matthewthomasbeck/Prowl/frontend/src/assets/earth-map-4k.jpg

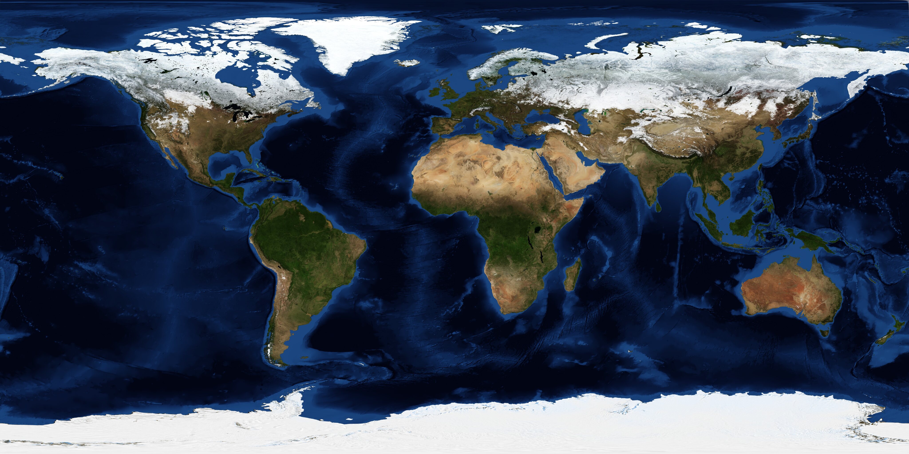
frontend/src/assets/earth-map-4k.jpg
