matthewthomasbeck/Prowl/frontend/src/assets/moon-ground.jpg

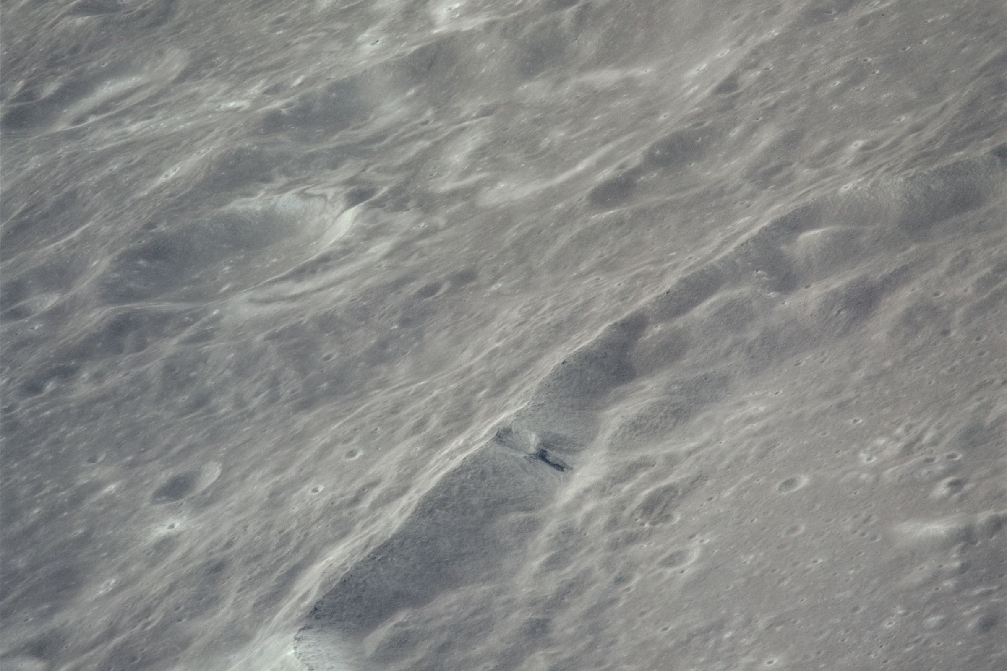
frontend/src/assets/moon-ground.jpg
