matthewthomasbeck/Prowl/frontend/src/assets/moon-map-2k.jpg

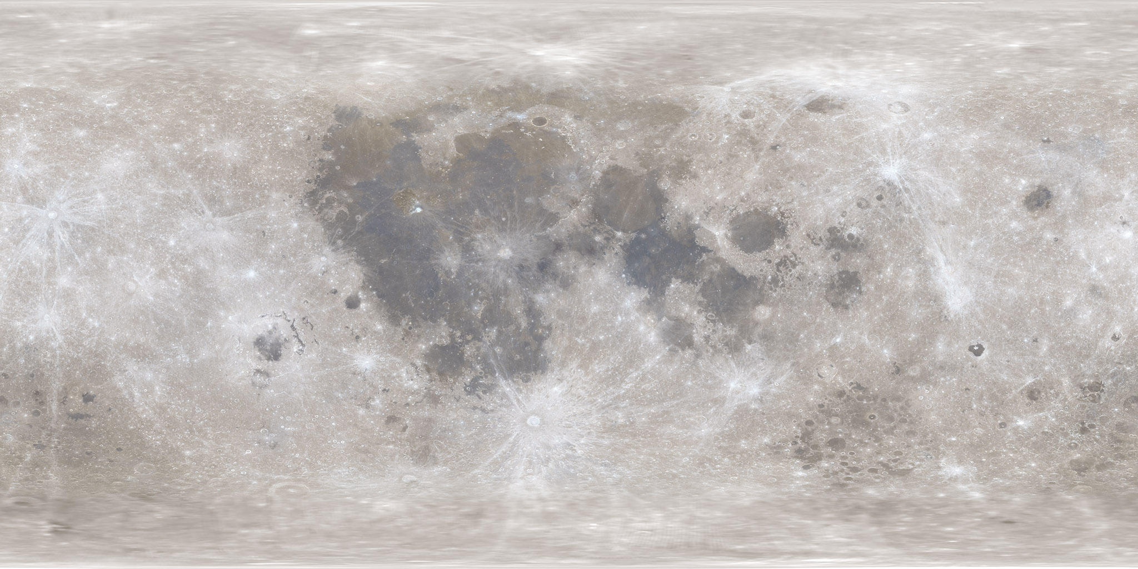
frontend/src/assets/moon-map-2k.jpg
