matthewthomasbeck/Prowl/images/frontend-saved_pictures.jpg

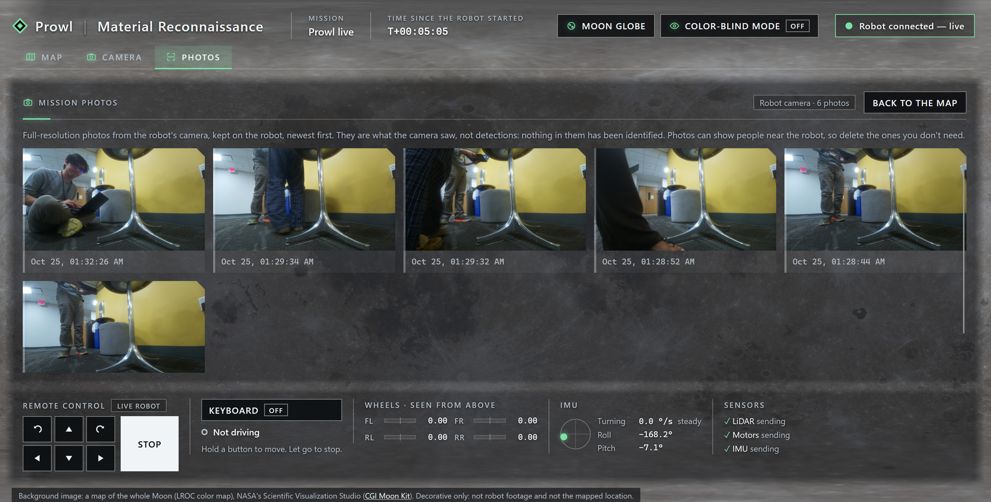
images/frontend-saved_pictures.jpg
