matthewthomasbeck/Prowl/images/propped_up_robot.jpg

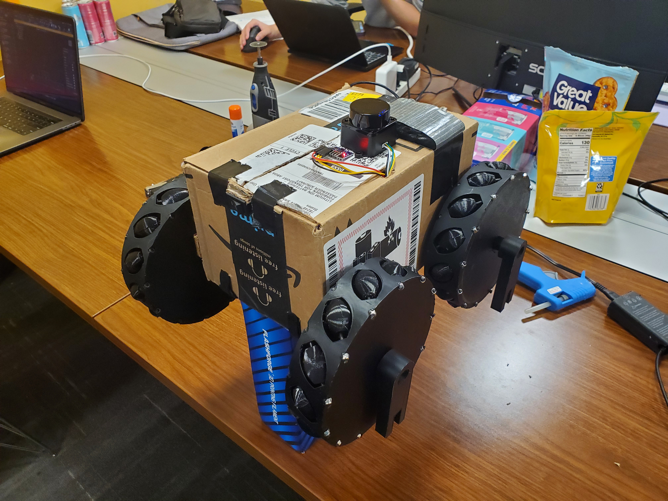
images/propped_up_robot.jpg
