matthewthomasbeck/Prowl/images/finished_robot-parts_exposed.jpg

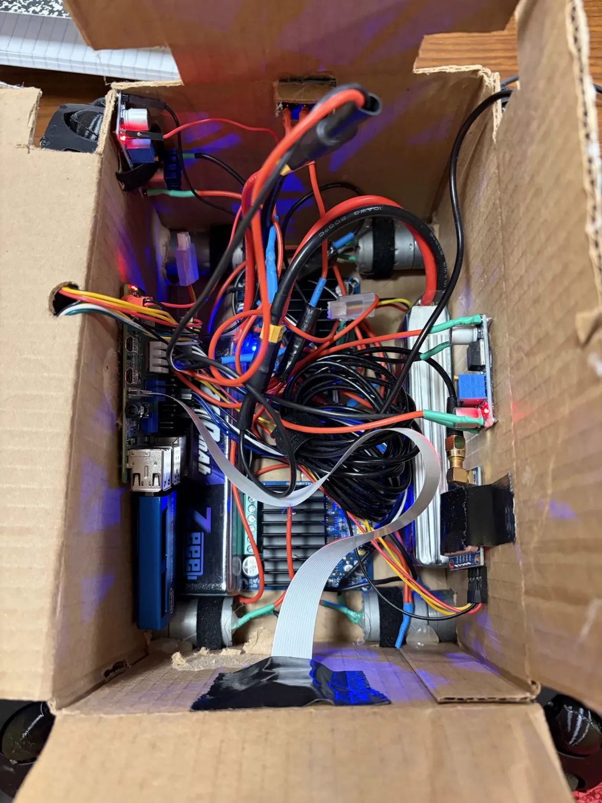
images/finished_robot-parts_exposed.jpg
