matthewthomasbeck/Prowl/images/parts_disassembled.jpg

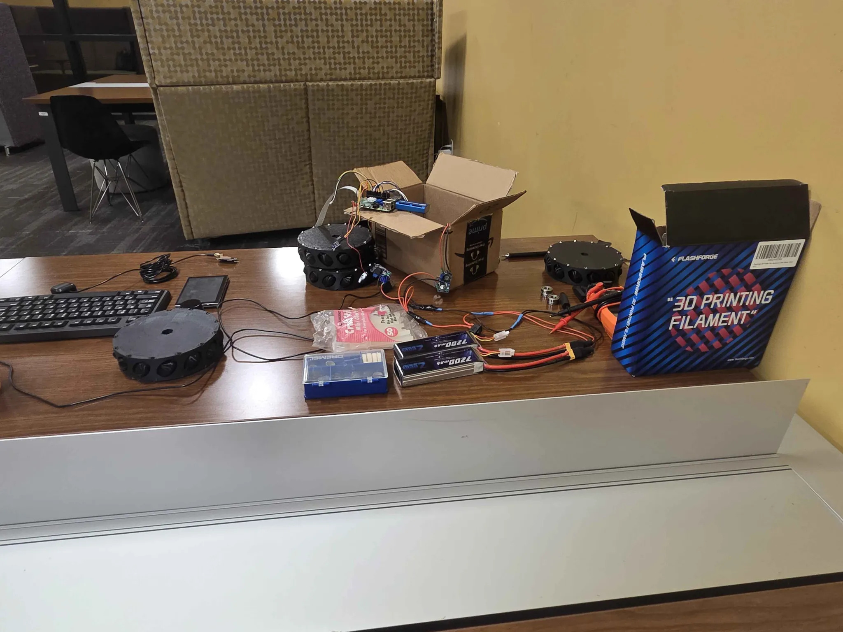
images/parts_disassembled.jpg
