matthewthomasbeck/Prowl/3d_parts/buttress.stl

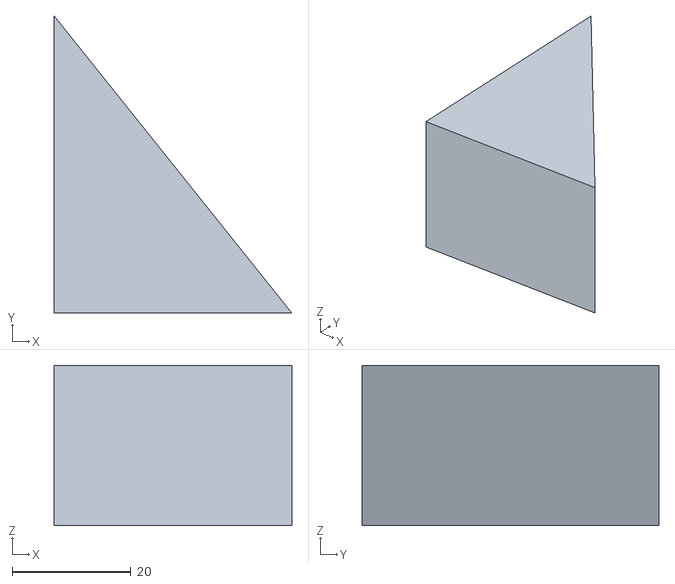
[picture p16: CAD file, 2026-10-25]
3d_parts/buttress.stl
40.0 x 50.0 x 27.0
