matthewthomasbeck/Prowl/3d_parts/connector_arm.stl

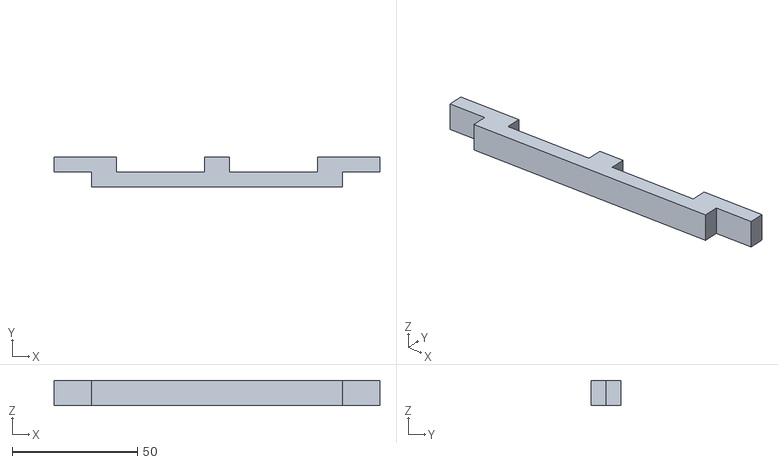
[picture p17: CAD file, 2026-10-24]
3d_parts/connector_arm.stl
130.0 x 12.0 x 10.0
