matthewthomasbeck/Prowl/3d_parts/t_bracket.stl

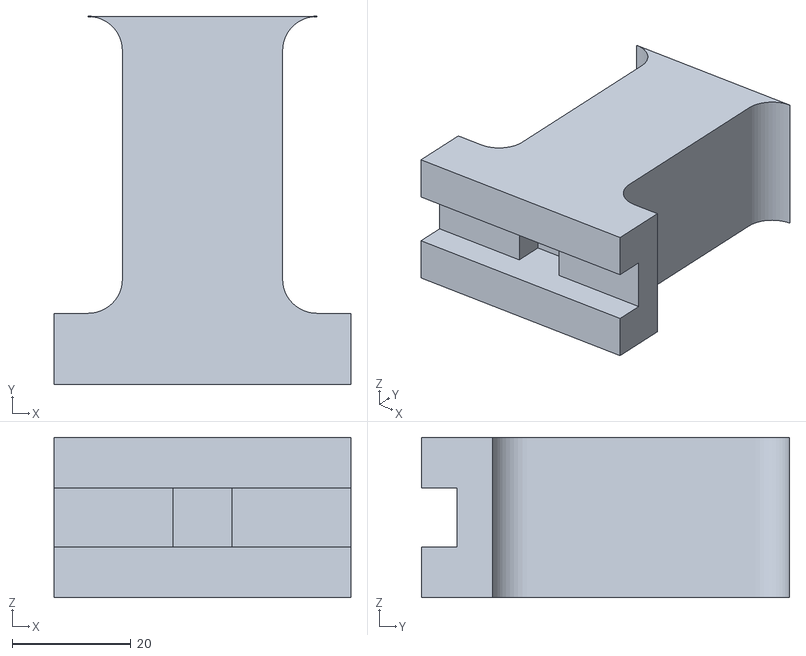
[picture p18: CAD file, 2026-10-24]
3d_parts/t_bracket.stl
50.0 x 62.0 x 27.0
