matthewthomasbeck/Prowl/3d_parts/wheel_arm.stl

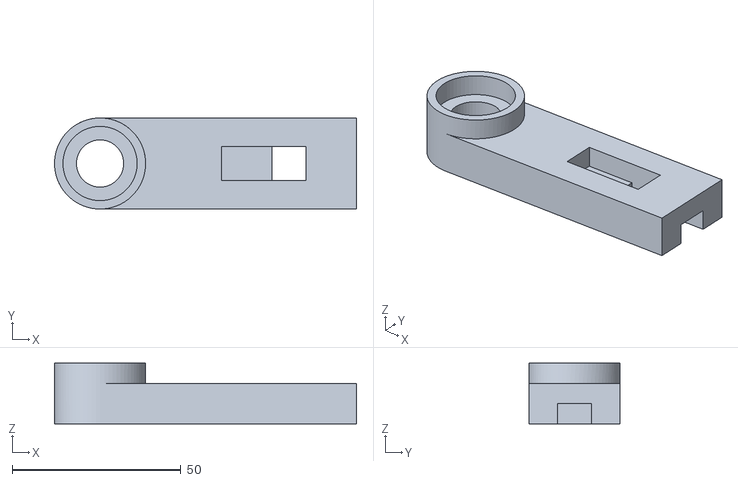
[picture p19: CAD file, 2026-10-24]
3d_parts/wheel_arm.stl
89.5 x 27.0 x 18.0
