matthewthomasbeck/Prowl/images/3d_printer.jpg

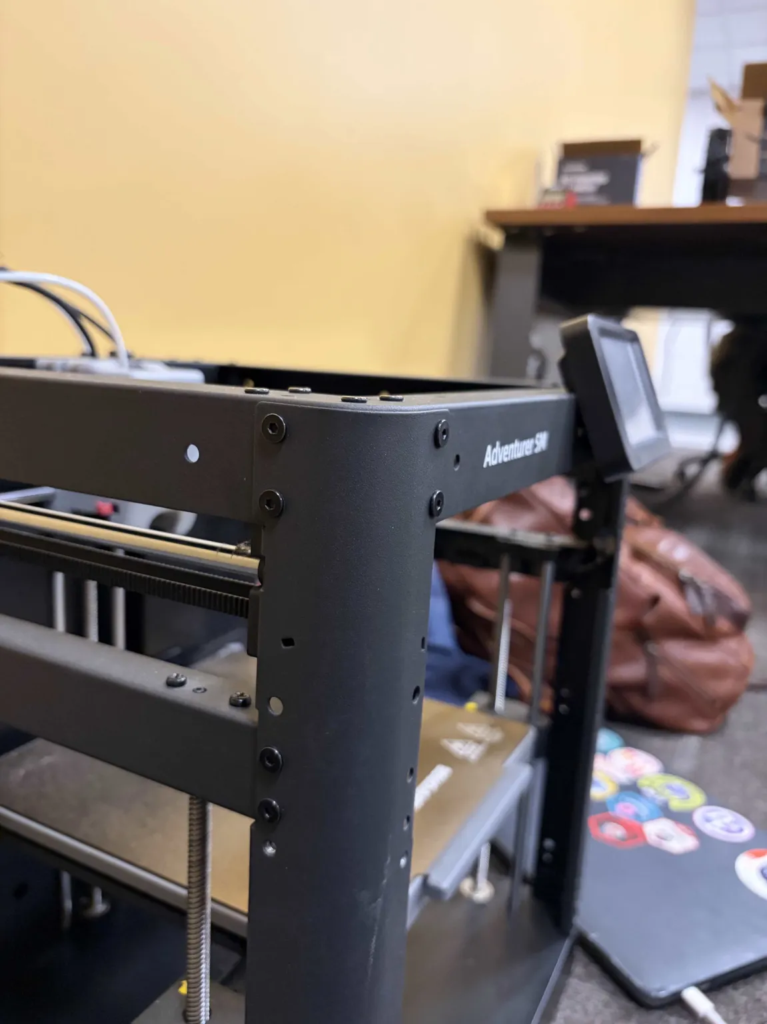
images/3d_printer.jpg
