matthewthomasbeck/Prowl/edge/src/prowl_dashboard_bridge/config/dashboard_bridge.yaml

dashboard_bridge:
  ros__parameters:
    host: 0.0.0.0           # listen on every network interface
    port: 8000              # the dashboard's web server forwards /ws and /api here (frontend/vite.config.js)
    drive_token: ""         # empty = anyone who can reach the port can drive; set one before using a shared network

    # Drive requests are fractions of these top speeds. Write them with a decimal point (1.0, not 1).
    # They're set so a full request is full motor duty: on Prowl's wheels, slow driving is harder on the
    # wheels than fast. If motor_driver.yaml's max_linear_speed or wheel geometry changes, change these too.
    linear_speed: 1.0       # m/s, forward/back and strafe: motor_driver's max_linear_speed
    angular_speed: 3.34     # rad/s: max_linear_speed / ((wheel_separation + wheel_base) / 2), rounded up
    drive_timeout: 0.3      # s without a drive request before a stop is sent (the motor driver's own is 0.5)

    mission_name: Prowl live  # shown as the mission in the dashboard's header

    # Where the LiDAR sits on the robot (base_link), for placing scan points around the robot. TODO: measure.
    laser_x: 0.0            # m forward
    laser_y: 0.0            # m left
    laser_yaw: 0.0          # rad counter-clockwise

    # How often the dashboards get each topic (the newest message wins in between).
    max_scan_points: 180
    scan_rate: 5.0          # Hz
    motor_status_rate: 10.0 # Hz
    imu_rate: 5.0           # Hz: each imu message is the average of the readings since the last one
    gps_rate: 2.0           # Hz: the GPS driver sends a fix once a second

    stale_after: 2.0        # s: the robot counts as connected while the LiDAR, motors, IMU, camera or GPS sent something this recently

    # Every photo the camera takes is kept here, for the dashboard's photos page. A relative path starts where
    # the bridge was started (edge/ in the dev container). Past max_photos (about 1 MB each), the oldest goes.
    photo_dir: data/photos
    max_photos: 200
