matthewthomasbeck/Prowl/(commit log)

2026-10-24 Designed adequate wheel arm
    [wheel_arm.stl]
2026-10-24 Added t bracket
    [t_bracket.stl]
2026-10-24 Add Prowl frontend dashboard (basic layout, demo mode)
    Minimal React + Vite + JavaScript app with plain CSS, in frontend/.
    Prowl heading and connection status, a clear "Demo mode - robot not
    connected" banner, and placeholders for the map and camera plus an
    observations panel. No UI library, no backend address, and no real data:
    the connection method and data format are not decided yet.
    The README documents how to run it and notes AI assistance.
2026-10-24 Replace basic frontend with the finished Prowl dashboard
    Mission-style React dashboard with clearly labeled simulated data:
    zoomable Moon exploration map, interactive Moon globe, points of
    interest and simulated obstacles, sample inspector with local-only
    "Queued locally - demo only" review queue, camera placeholder,
    mobile/tablet/desktop layouts, and a color-blind mode.
    No backend addresses or real robot readings; the README documents
    AI assistance, starter files and the two credited NASA images.
2026-10-24 edge: motor driver, motor panel, Docker dev setup, roadmap
    - Docker dev environment (docker/Dockerfile, docker/dev.sh) that runs ROS2
    Jazzy on the Pi, plus ./prowl to start it, build, and open the motor panel
    - prowl_motor_driver: mecanum /cmd_vel mixing, per-wheel /wheel_cmd,
    acceleration ramp, command timeout, dry-run mode
    - motor_panel: terminal UI with hold-to-drive, strafing, wheel tests, and
    live mode for one run only
    - README.md: setup, usage, safety and troubleshooting
    - ROADMAP.md: LD19 LiDAR and MPU6050 drivers, Cartographer mapping, and the
    rosbridge link to the dashboard
    [motor_driver.yaml]
2026-10-24 Connect the dashboard to a live backend for the space pitch
    Backend (backend/): FastAPI server between the rover and the dashboard.
    - Rover streams pose, LiDAR map, scans, findings and status over /ws/robot;
    camera samples get codes P-001.., LiDAR obstacles O-001..
    - Dashboards get a snapshot then live updates; review status, notes and
    queued reports are saved per run and shared, during and after a run.
    - Every run is recorded and can be replayed; resume after Wi-Fi drops.
    - tools/fake_robot.py simulates the rover in a mock Moon area (LiDAR
    raycasting, obstacle clustering, camera finds), labeled as simulator data.
    - deploy/setup_ec2.sh sets up Amazon Linux 2023 in one command and
    bui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
2026-10-24 edge: LD19 LiDAR and MPU6050 IMU drivers, vibration-proof gyro calibration
    - prowl_ld19_driver: LD19 packet parser with CRC-8, scan assembly into a
    720-bin LaserScan on /scan, terminal viewer, unit tests.
    - prowl_mpu6050_driver: MPU6050 over I2C, raw-to-SI conversion, startup
    gyro bias calibration, /imu/data_raw at 100 Hz, terminal monitor, unit
    tests. The calibration's stillness check averages over 0.1 s (one LiDAR
    rotation) so the LiDAR's 10 Hz vibration no longer reads as movement.
    - docker: pass /dev/ttyS0 and /dev/i2c-1 into the container, add i2c-tools.
    - README/ROADMAP: sensor driver docs, actual wiring, Phases 1-2 done,
    calibration results and remaining open items.
    Co-Auth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
    [conversions.cpp, gyro_bias.cpp, i2c_device.cpp, laser_scan.hpp]
2026-10-24 Added connector bar part
    [connector_arm.stl]
2026-10-24 edge: dashboard bridge (Node.js ROS2 node) with a browser test page
    prowl_dashboard_bridge serves the robot's ROS2 topics to the dashboard over
    the backend's /ws/dashboard WebSocket protocol (PROTOCOL.md): /robot_pose,
    /scan, /map and /motor_status out, hold-to-drive requests in on /cmd_vel,
    with a drive token, speed limits and stop-on-silence.
    GET / now serves a small test page (no libraries) showing the LiDAR scan,
    wheel duties and topic ages, with hold-to-drive buttons and keys.
    test_page.launch.py starts the LD19 driver, the motor driver (dry run
    unless live:=true) and the bridge. Tested end to end in dry run with the
    real LD19.
    Frontend: useDrive.js hold-to-drive hook; useProwlLink pa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
2026-10-24 edge: instructions for hooking the dashboard up to the robot bridge
    FRONTEND_HOOKUP.md tells an agent how to connect frontend/ to the bridge:
    the drive-protocol mismatch with the backend (streamed drive vs click-step
    commands), detecting the bridge from its snapshot, showing scan and
    motor_status, using useDrive for hold-to-drive, merging with the
    remote-control branch, testing in dry run, and safety rules.
2026-10-25 Remove unfinished prowl_brain SLAM prototype.
2026-10-25 Refine peripheral descriptions in README.md
    Updated sections on LIDAR, IMU, and DCMC in README.
2026-10-25 Dashboard: Map, Camera and Photos pages, and fix the lag on the robot
    Frontend (connected straight to the robot's bridge):
    - Three pages switched by tabs under the header: Map, Camera (#camera) and
    Photos (#photos). The remote control sits along the bottom of every page,
    and keeps its keyboard switch when the page changes.
    - The live video moved to the Camera page; the map page's camera panel links
    to it. No more collapsing or resizing.
    - The video pulls frame.jpg one frame at a time instead of the MJPEG stream,
    so it can't fall seconds behind on a slow link or a busy browser.
    - Performance: no backdrop-filter blur and no looping animations on the
    robot; LiDAR, wheel and IMU readin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
    [camera_driver.yaml, dashboard_bridge.yaml, jpeg.hpp]
2026-10-25 Added buttress part and images directory
    [buttress.stl]
2026-10-25 Complete refactor (#8)
    * Remove the backend, VS Code tasks and leftover root files
    The dashboard talks straight to the robot's bridge, so backend/ (FastAPI hub, simulator, EC2 deploy) and the VS Code tasks that only ran it are gone, along with a tracked .DS_Store and an empty root package-lock.json. The three .gitignore files are now one at the root (it also ignores .DS_Store properly; the old pattern only matched a directory).
    * Bridge: drop the test page, the MJPEG stream, pose/map and the backend's fields
    The dashboard covers everything the test page did, and it pulls frame.jpg rather than the MJPEG stream (camera_rate went with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
2026-10-25 GPS: u-blox 7 driver, and a GPS page with an Earth globe
    - prowl_gps_driver: reads the u-blox 7's NMEA output on UART4 (/dev/ttyAMA4, header pins 21 and 24) and
    publishes /gps/fix (NavSatFix), /gps/vel (TwistStamped) and /gps/status (DiagnosticStatus, with the
    satellites in view). Written from the u-blox 7 protocol specification and the MAX-7/NEO-7 hardware
    integration manual; listens only. Unit tests for the parsing, the receiver state and the conversions.
    - robot.launch.py starts it; dev.sh passes /dev/ttyAMA4 into the container.
    - Bridge: one `gps` message to the dashboard, and the GPS in status and the snapshot.
    - Dashboard: a GPS page with the robot on a globe of the Earth (NASA B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
    [dashboard_bridge.yaml]
