matthewthomasbeck/Prowl/images/prototype-exposed_pcbs.jpg

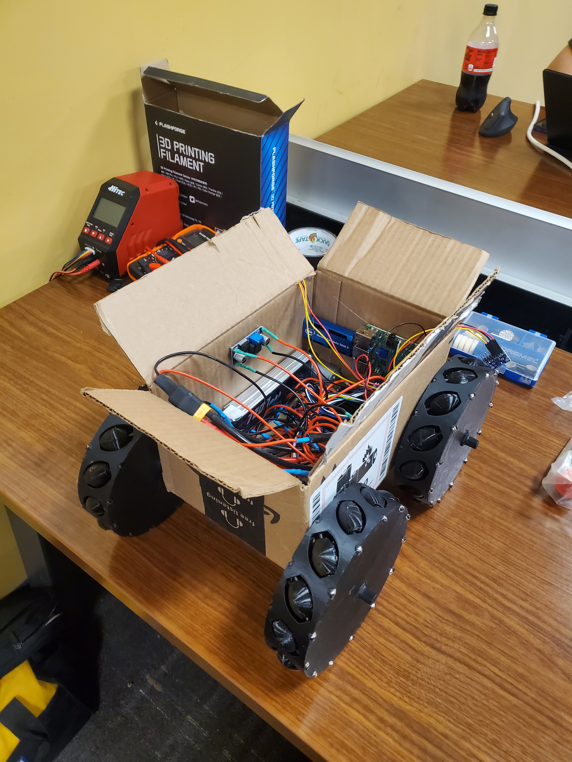
images/prototype-exposed_pcbs.jpg
