matthewthomasbeck/Prowl/images/20261024_013115.jpg

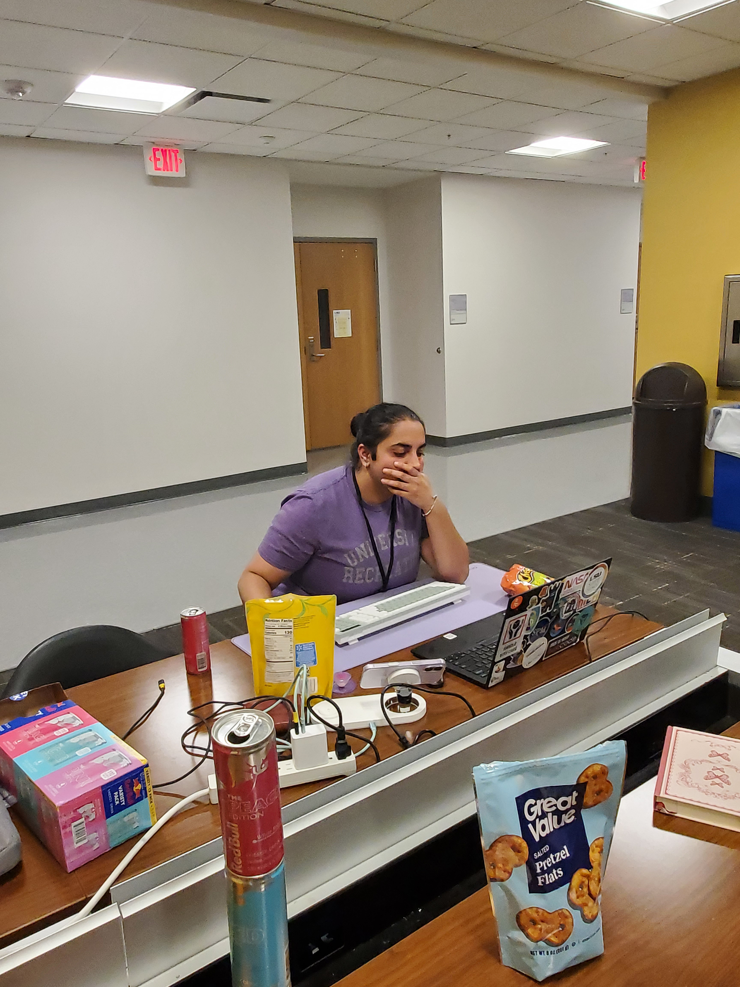
[picture p6: images/ishaan_working.jpg]
images/20261024_013115.jpg
